girikuncoro/guitar-scale/pics/simulasiproteus2.jpg

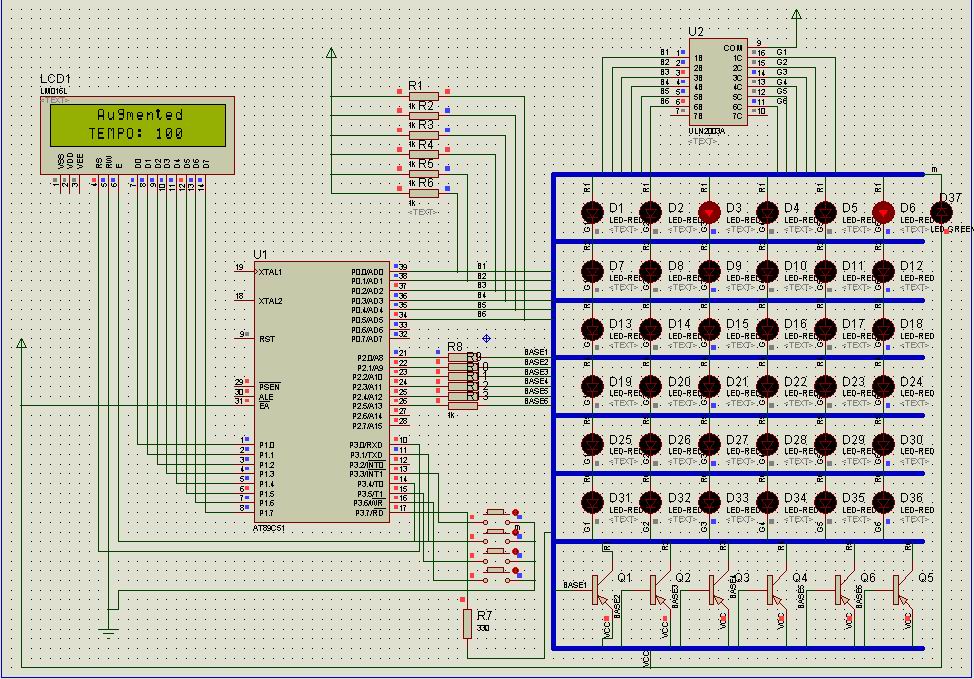
pics/simulasiproteus2.jpg
