girikuncoro/guitar-scale/pics/DSC00021.JPG

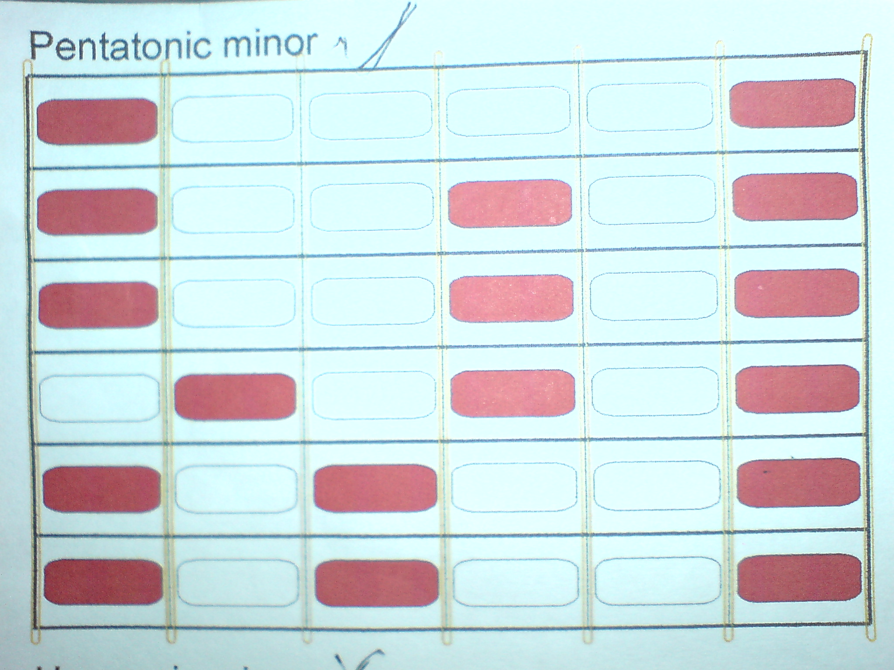
pics/DSC00021.JPG
