girikuncoro/guitar-scale/README.md

# guitar-scale
Assembly project for interactive guitar scaling product. Did the project together with my friend Ardya Dipta (http://ardyadipta.com).
