girikuncoro/guitar-scale/pics/Capture_2.jpg

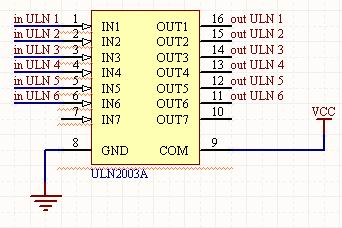
pics/Capture_2.jpg
