girikuncoro/guitar-scale/pics/Capture_35.jpg

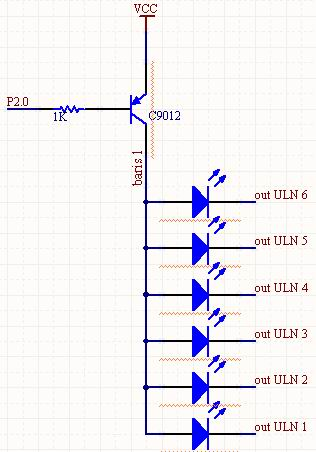
pics/Capture_35.jpg
