girikuncoro/guitar-scale/pics/DSC00001.JPG

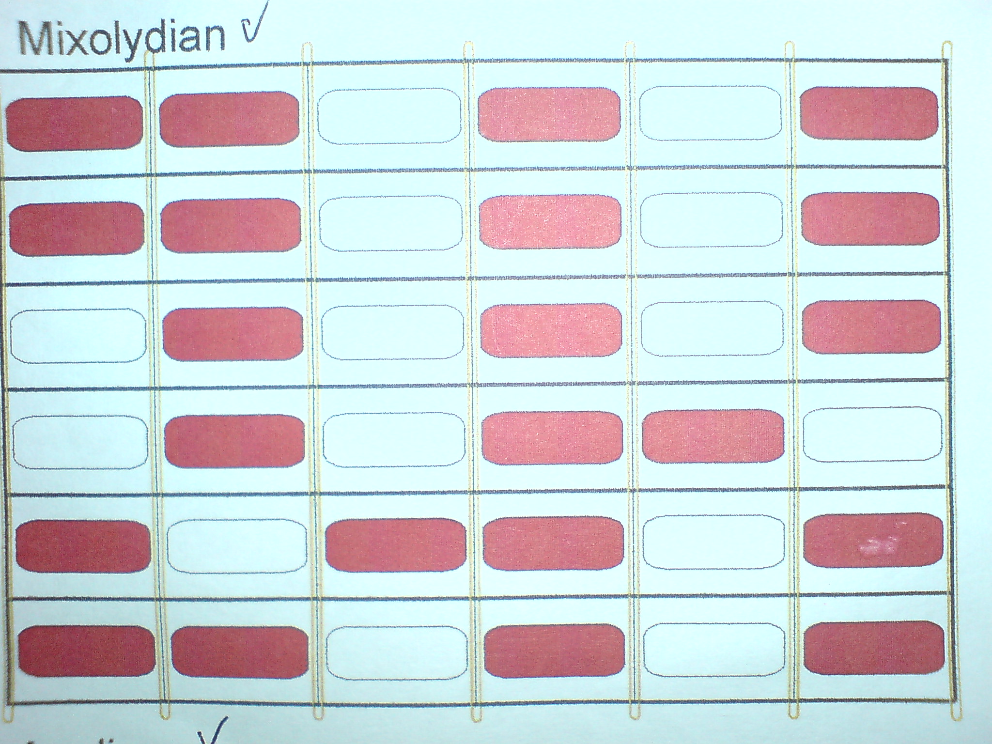
pics/DSC00001.JPG
