girikuncoro/guitar-scale/pics/DSC00002.JPG

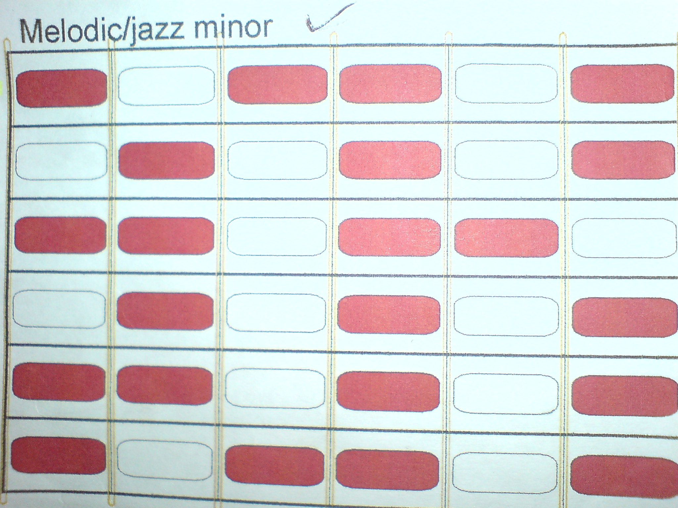
pics/DSC00002.JPG
