girikuncoro/guitar-scale/pics/DSC00003.JPG

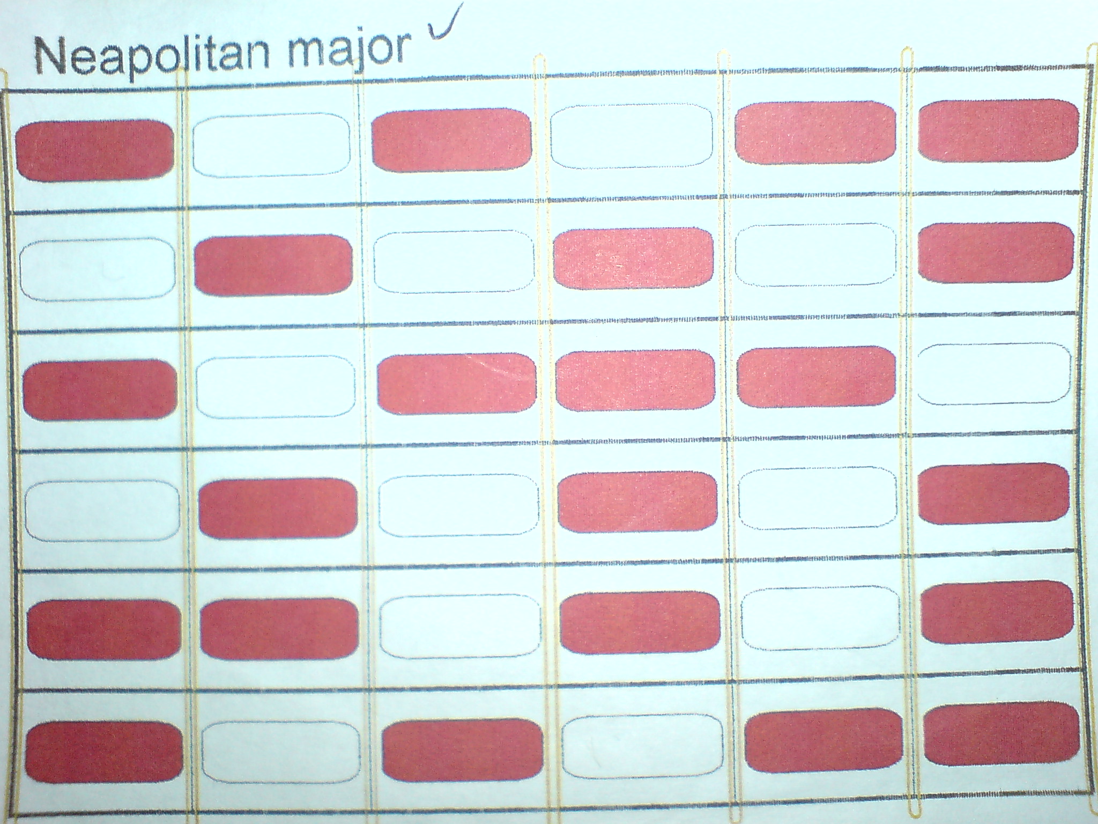
pics/DSC00003.JPG
