girikuncoro/guitar-scale/pics/DSC00004.JPG

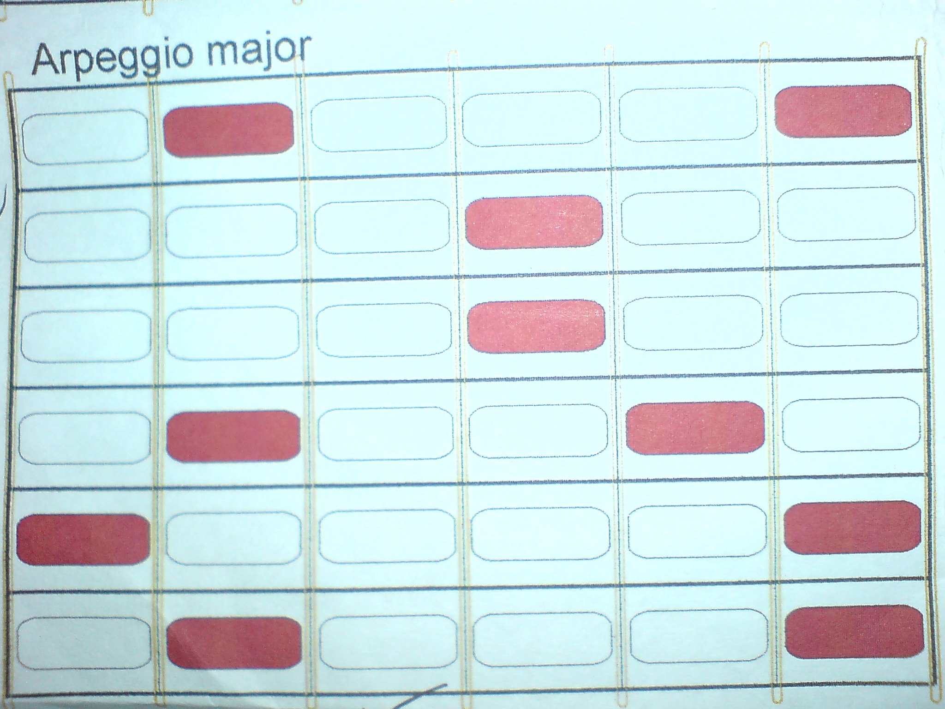
pics/DSC00004.JPG
