girikuncoro/guitar-scale/pics/DSC00005.JPG

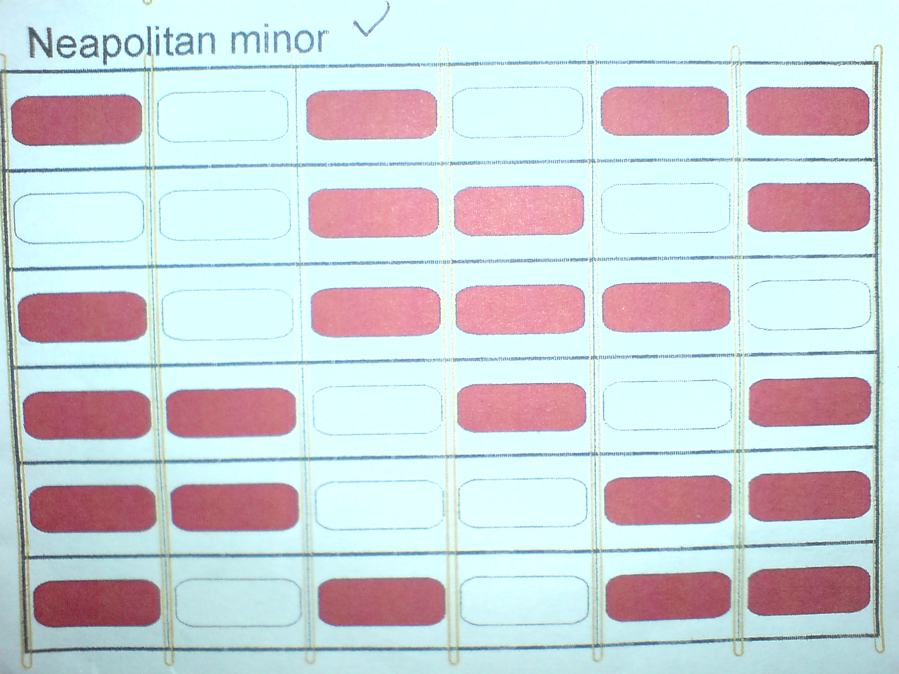
pics/DSC00005.JPG
