girikuncoro/guitar-scale/pics/DSC00006.JPG

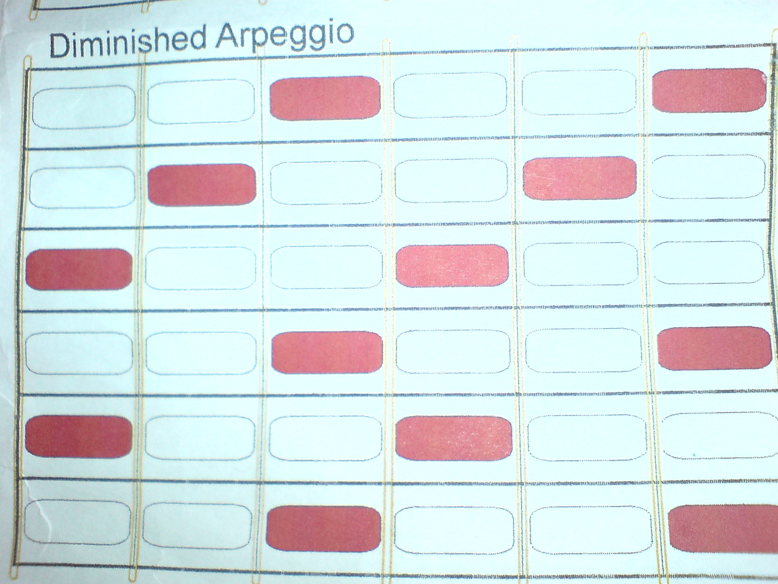
pics/DSC00006.JPG
