girikuncoro/guitar-scale/pics/DSC00007.JPG

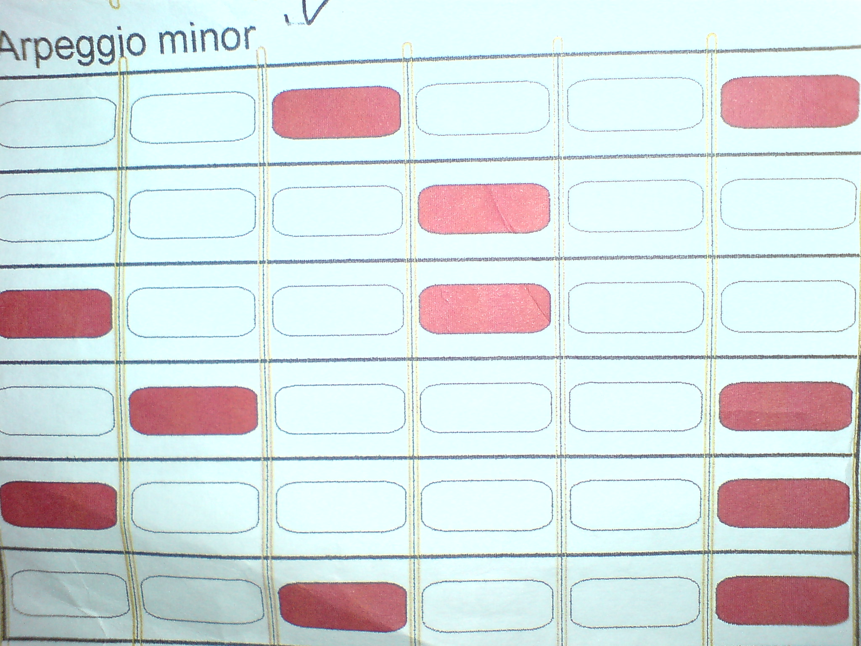
pics/DSC00007.JPG
