girikuncoro/guitar-scale/pics/DSC00008.JPG

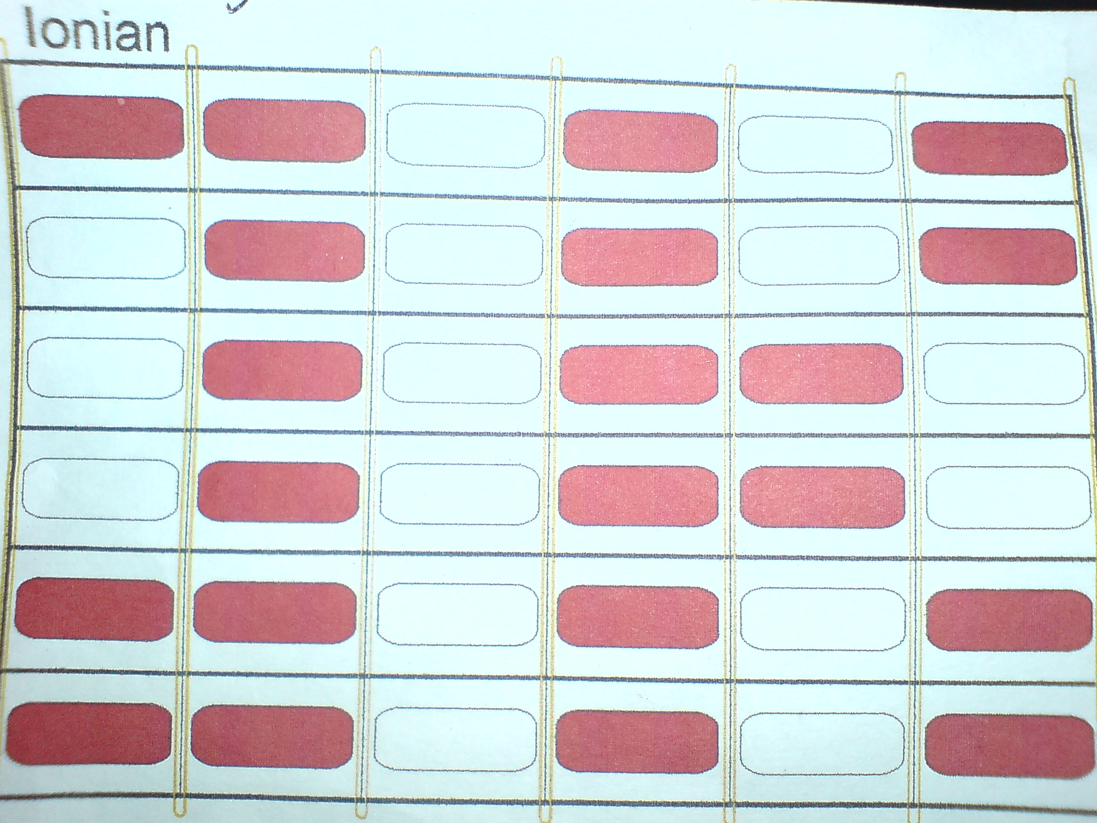
pics/DSC00008.JPG
