girikuncoro/guitar-scale/pics/DSC00009.JPG

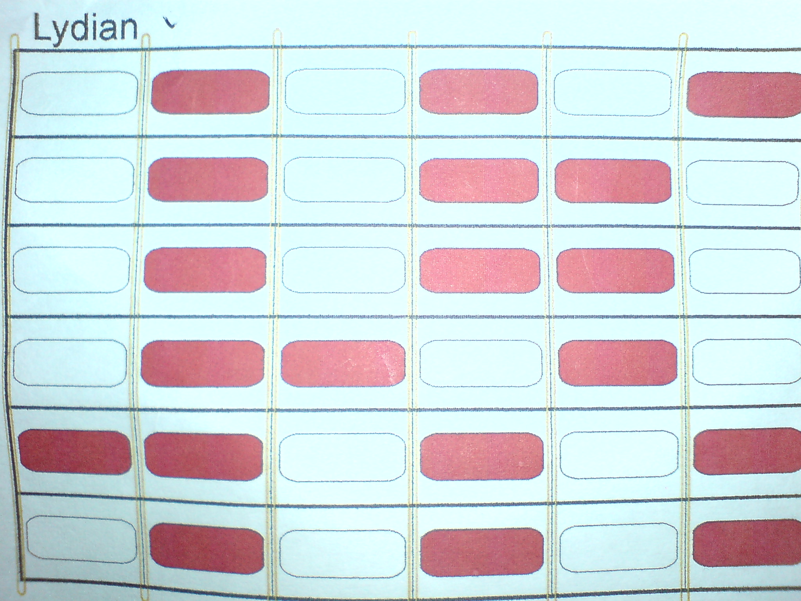
pics/DSC00009.JPG
