girikuncoro/guitar-scale/pics/DSC00010.JPG

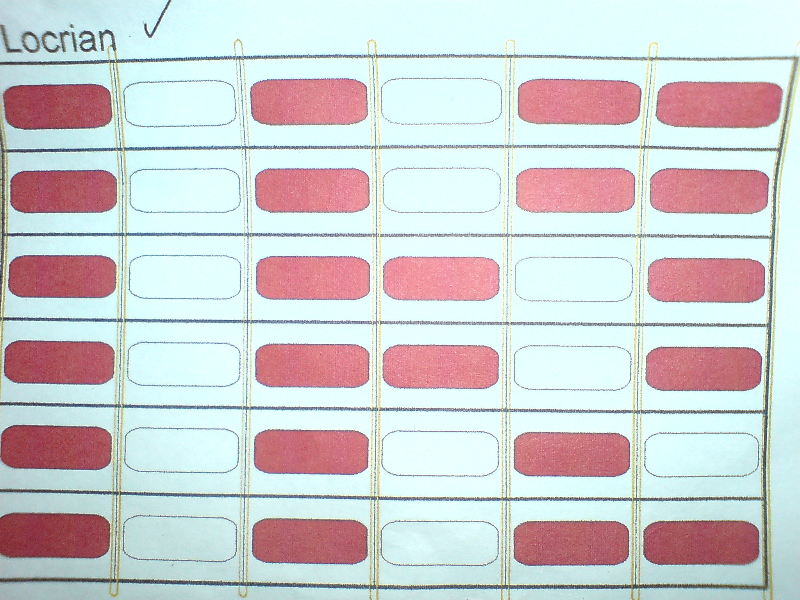
pics/DSC00010.JPG
