girikuncoro/guitar-scale/pics/DSC00011.JPG

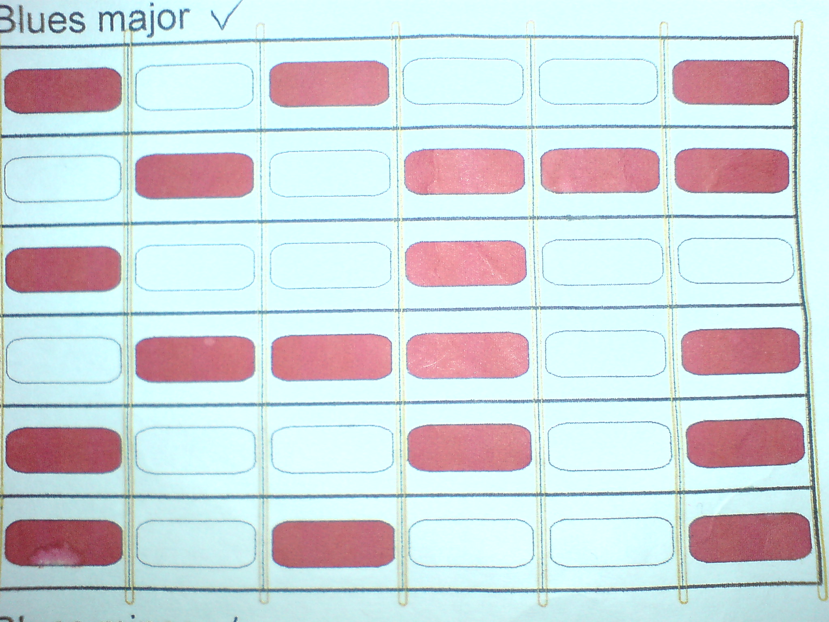
pics/DSC00011.JPG
