girikuncoro/guitar-scale/pics/DSC00012.JPG

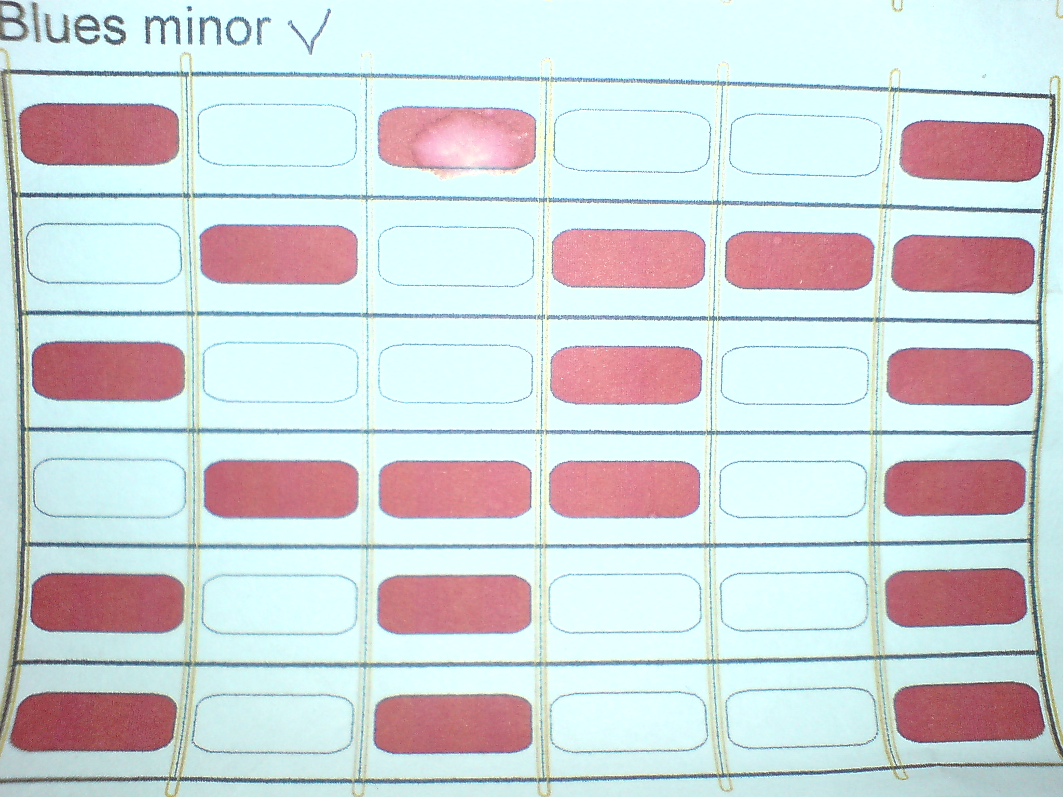
pics/DSC00012.JPG
