girikuncoro/guitar-scale/pics/DSC00013.JPG

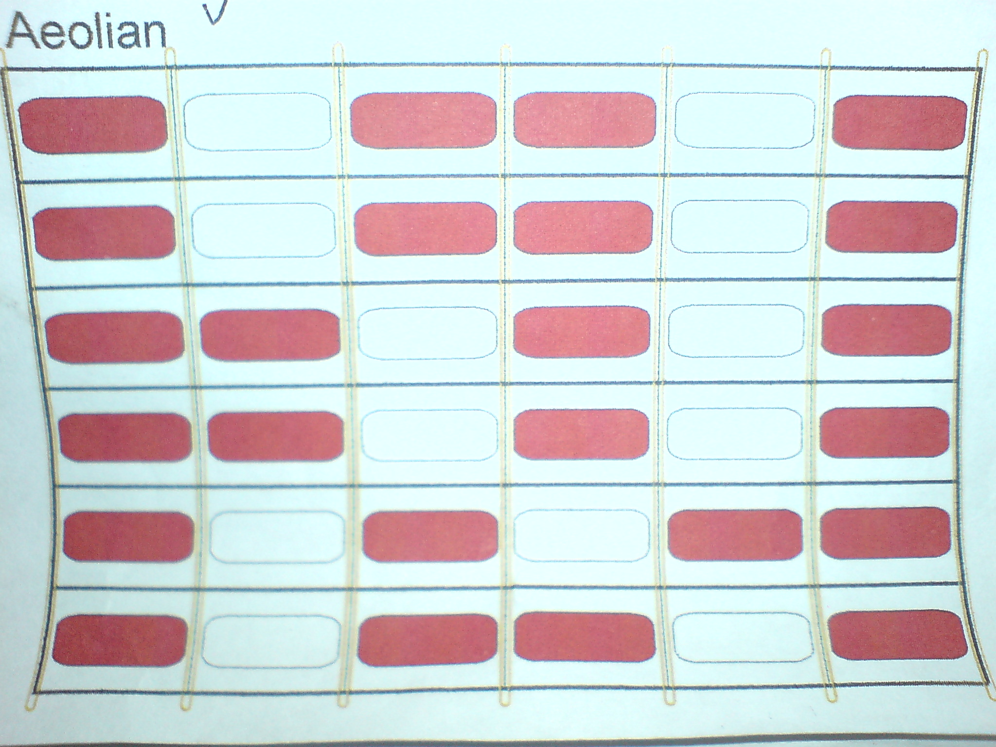
pics/DSC00013.JPG
