girikuncoro/guitar-scale/pics/DSC00014.JPG

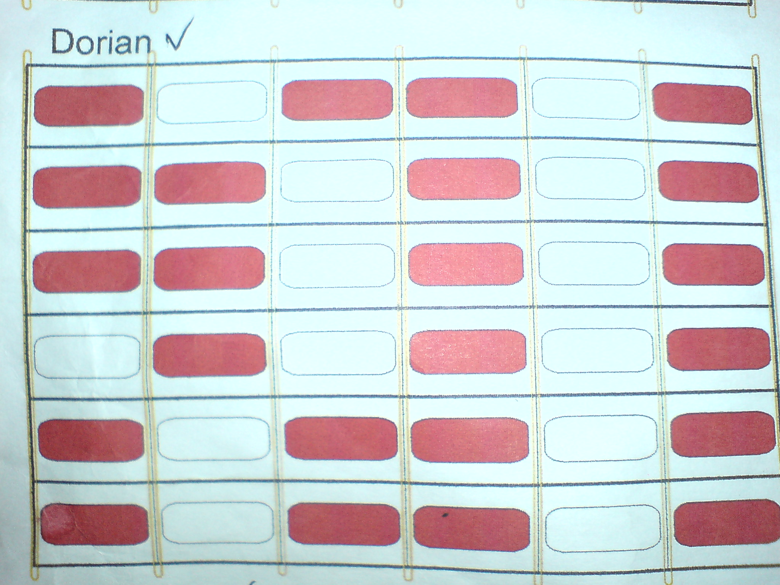
pics/DSC00014.JPG
