girikuncoro/guitar-scale/pics/DSC00015.JPG

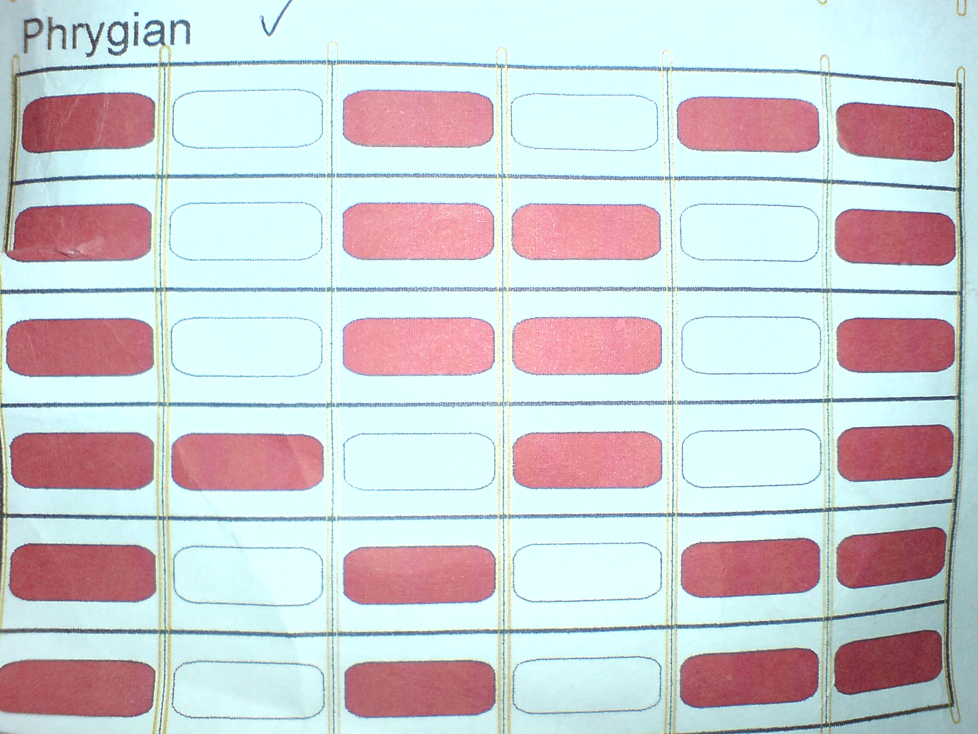
pics/DSC00015.JPG
