girikuncoro/guitar-scale/pics/DSC00016.JPG

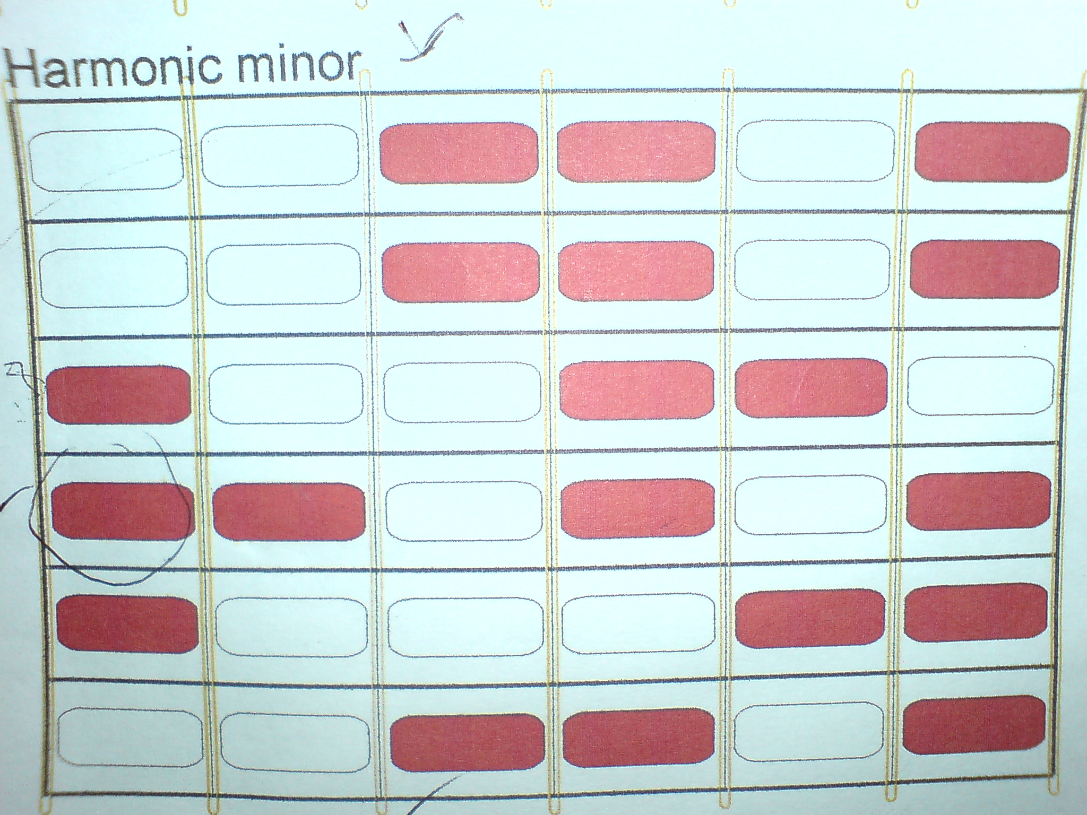
pics/DSC00016.JPG
