girikuncoro/guitar-scale/pics/DSC00017.JPG

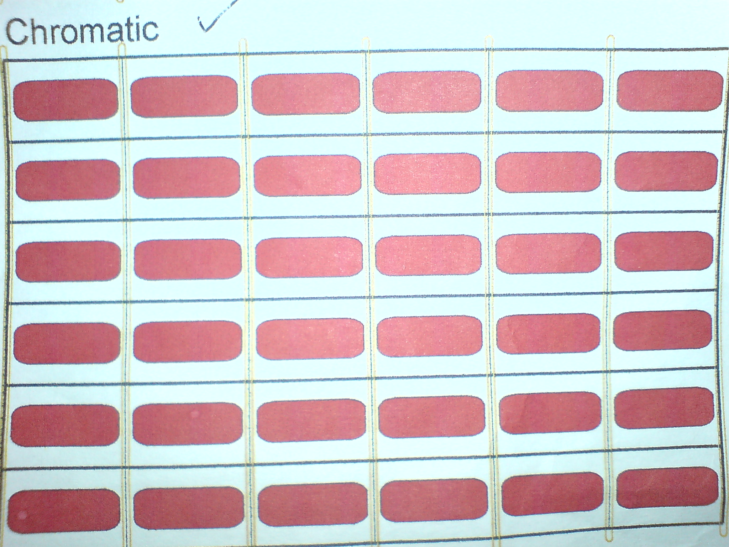
pics/DSC00017.JPG
