girikuncoro/guitar-scale/pics/DSC00018.JPG

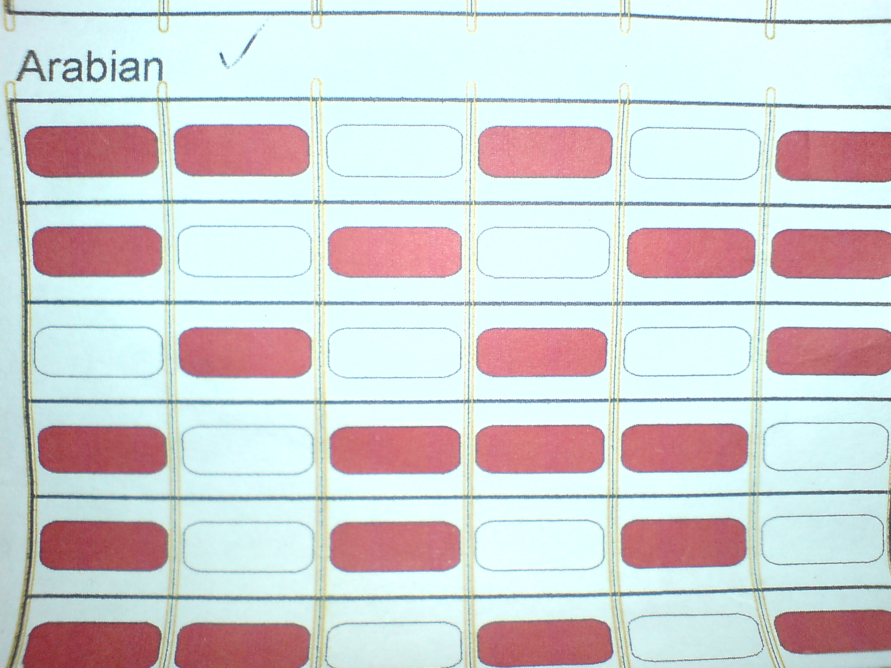
pics/DSC00018.JPG
