girikuncoro/guitar-scale/pics/DSC00019.JPG

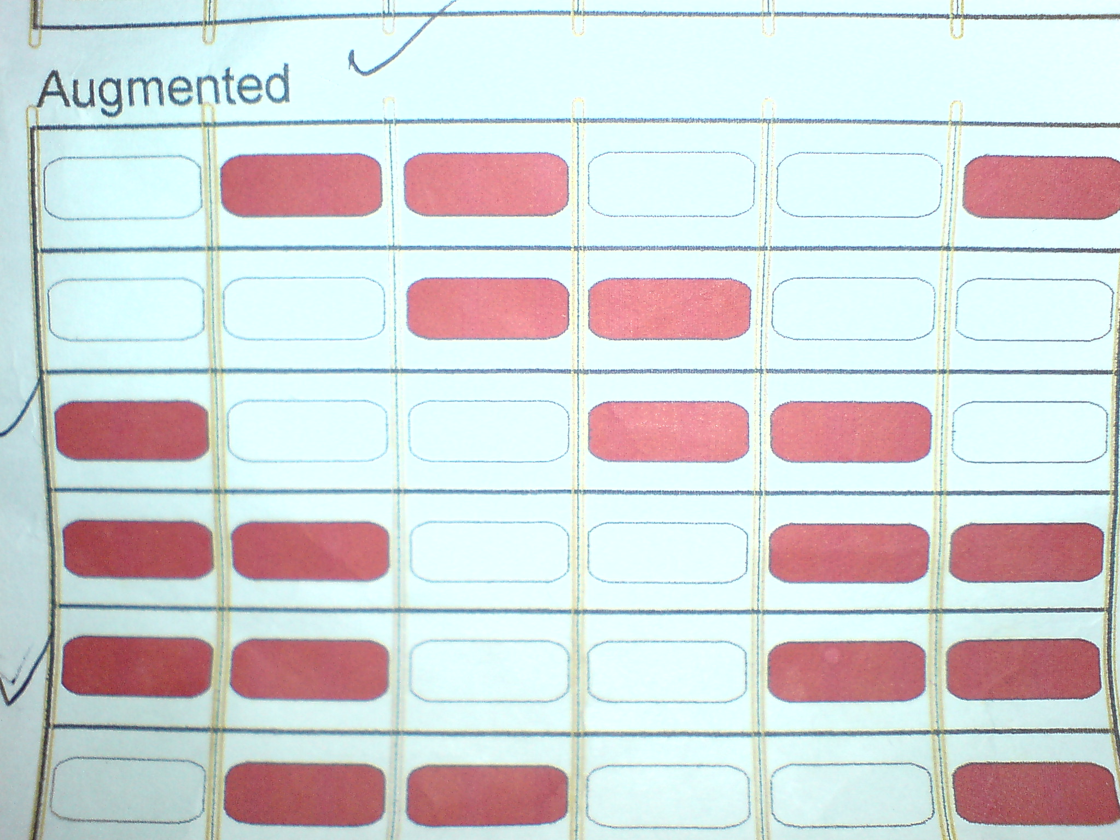
pics/DSC00019.JPG
