girikuncoro/guitar-scale/pics/DSC00020.JPG

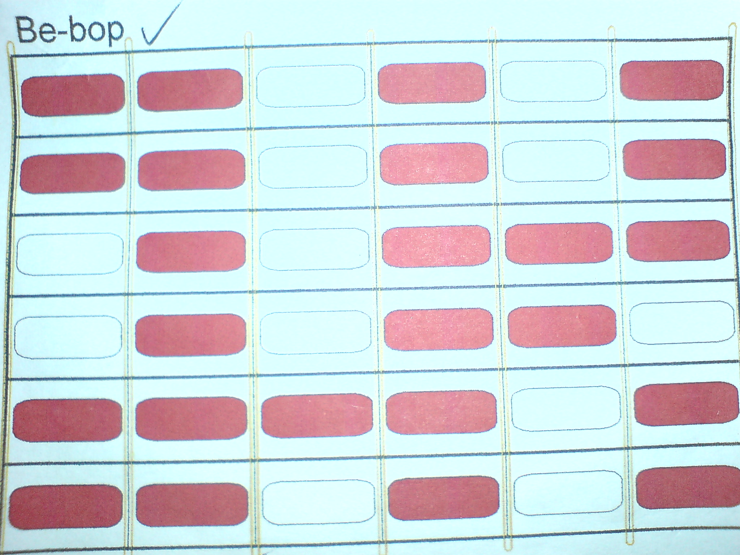
pics/DSC00020.JPG
