girikuncoro/guitar-scale/pics/DSC00022.JPG

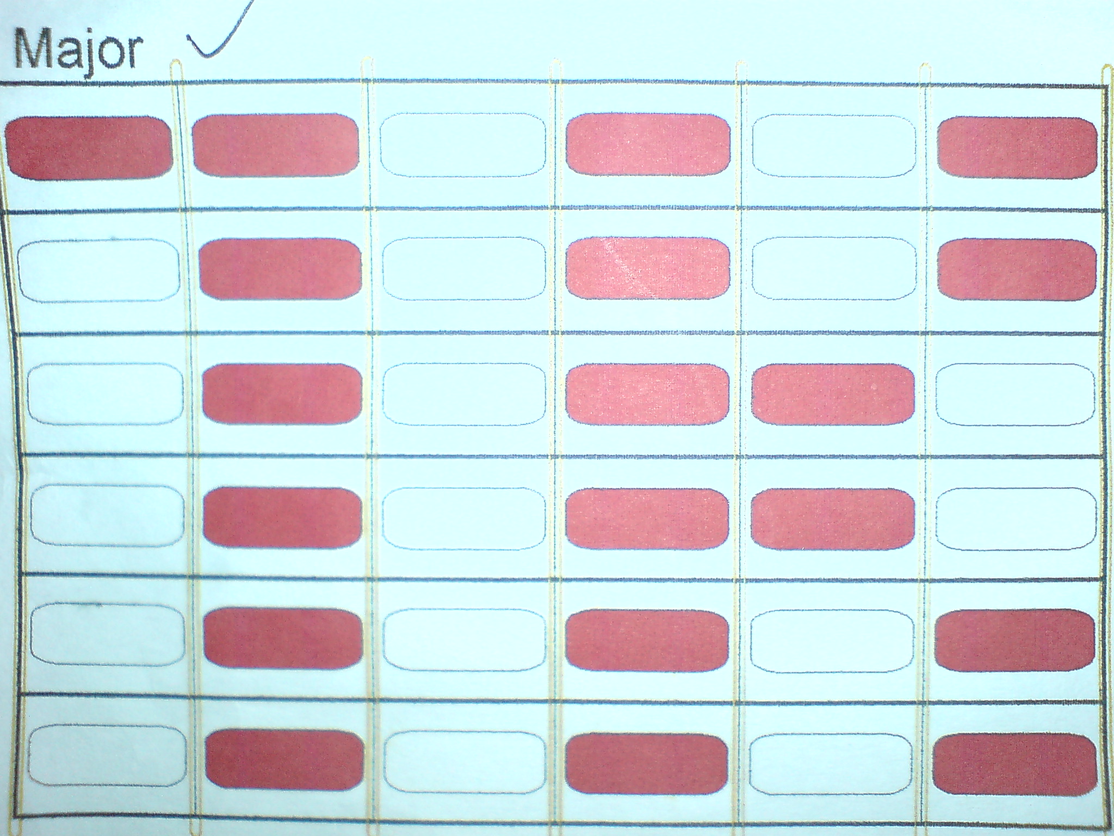
pics/DSC00022.JPG
