girikuncoro/guitar-scale/pics/DSC00023.JPG

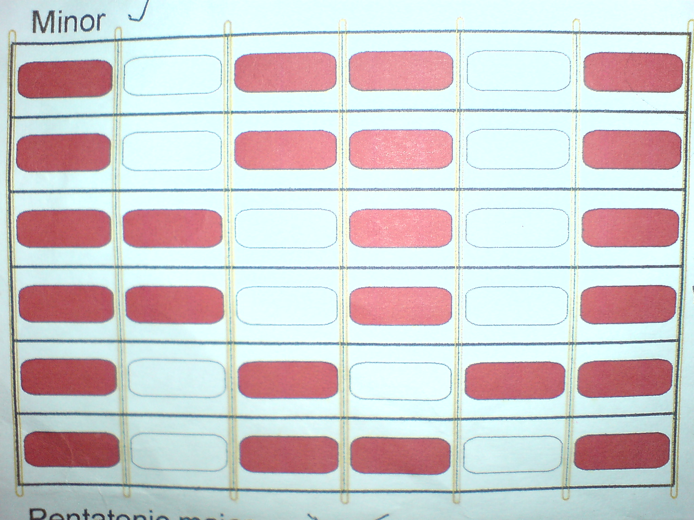
pics/DSC00023.JPG
