girikuncoro/guitar-scale/pics/DSC00024.JPG

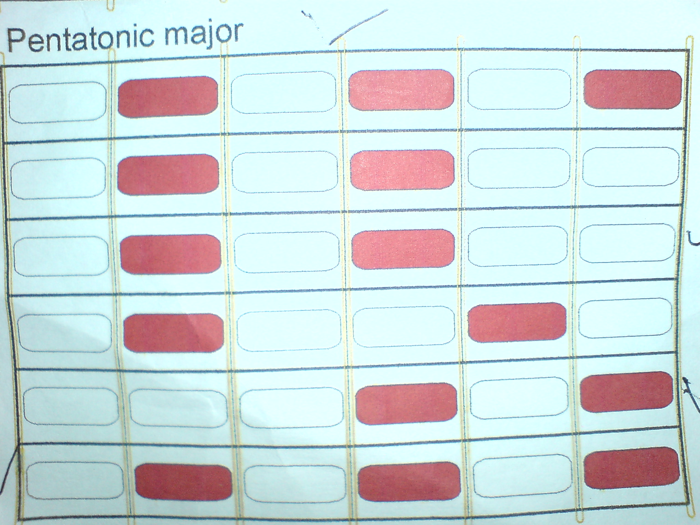
pics/DSC00024.JPG
