girikuncoro/guitar-scale/pics/DSC00109.jpg

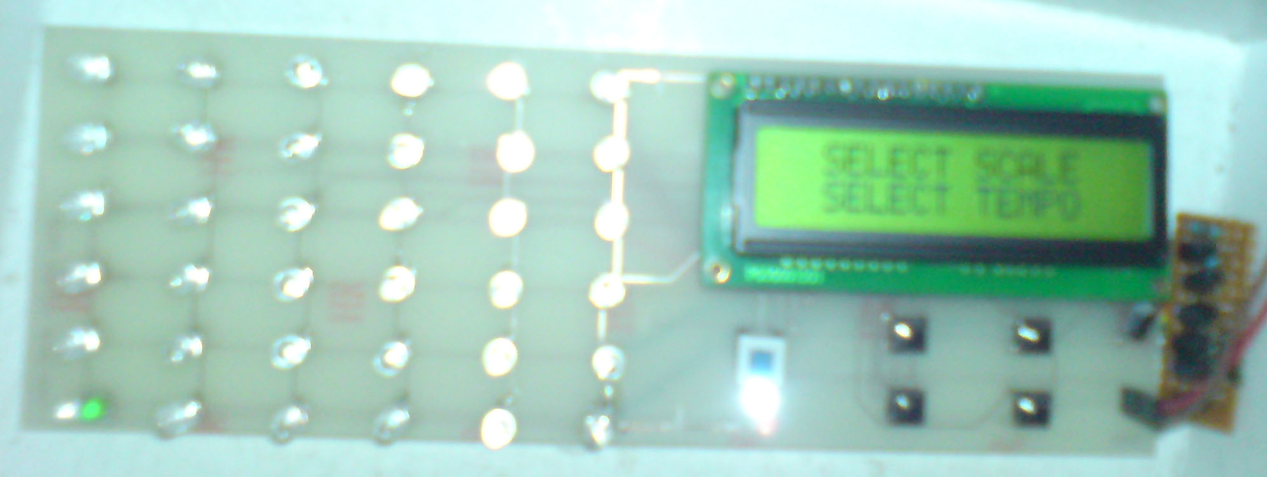
pics/DSC00109.jpg
