girikuncoro/guitar-scale/(list of files, drawings)

Other design files:
PCB/gitar final/gitarukuranjadi.PCBDOC
PCB/gitar final/gitarukuranjadi.PRJPCB
PCB/gitar final/gitarukuranjadi.SCHDOC
PCB/gitarjadi.PCBDOC
PCB/gitarjadi.SCHDOC
PCB/gitarukuran dah bener jadi.PCBDOC
PCB/guitarheroes.PRJPCB
simulasi proteus/designfinish.DSN
